RalphWystup/Waermebild-Fusion-mit-ESP32-CAM-und-AMG8833/(commit log)

2026-09-29 Waermebild-Fusion: ESP32-CAM und AMG8833, Kamerabild und Waermebild uebereinander
    Eine ESP32-CAM streamt das Kamerabild, ein AMG8833 mit 64 Thermoelementen liefert
    das Waermebild, ein Browser legt beides deckungsgleich uebereinander. Manuskript,
    Seite mit gezeichneter Szene, Sensormatrix, Display und Parallaxe.
2026-09-30 Angaben fuer Zenodo
    Titel, Beschreibung, Schlagwoerter, Lizenz und Verweise, damit beim Archivieren
    nichts von Hand eingetippt werden muss.
2026-09-30 Kopfangaben fuer Suchmaschinen
    Kurzbeschreibung, kanonische Adresse, Vorschauangaben fuer geteilte Links und
    Strukturdaten nach schema.org — in der Seite und in der Weiterleitung. Die
    Angaben stammen aus derselben Quelle wie Startseite und Sitemap.
2026-09-30 Zitierangabe
    CITATION.cff: GitHub zeigt damit den Knopf "Cite this repository" mit fertigem
    Zitat, und Literaturverwaltungen koennen die Angabe auslesen. Ohne DOI und ohne
    Dritte.
